do-del/Board_Car/README.md

# Board_Car
Mini平衡小板车
项目目标：做一个非常简易小巧还能遥控的平衡小车
## 功能
- 自平衡
- 可遥控前进后退转弯

## 硬件构成
电路包括双路直流电机驱动、主控MCU、陀螺仪、电池充放电、调试电路组成，力求精简低成本
- 主控使用STM32F103CBT6，预留SWD调试接口,UART接口
- 陀螺仪使用MPU6050，I2C通讯
- 无线使用RF24无线模块，SPI通讯
- 电机驱动使用L9110SH桥驱动芯片，PWM控制
- 电池充放电使用IP5306，输出5V
