do-del/Board_Car/(list of files, cad)

Other CAD files:
Firmware/Board_Car_STC32/Objects/main.obj
Firmware/Mini_Receiver/Objects/main.obj
Firmware/STC32_TEST/Objects/main.obj
Firmware/Mini_Receiver/Objects/STARTUP.obj
Firmware/STC32_TEST/Objects/timer.obj
Firmware/Board_Car_STC32/Objects/uart.obj
Firmware/Mini_Receiver/Objects/pwm.obj
Firmware/STC32_TEST/Objects/pwm.obj
Firmware/STC32_TEST/Objects/uart.obj
Firmware/Mini_Receiver/Objects/uart.obj
Firmware/Mini_Receiver/Objects/RF24.obj
Firmware/STC32_TEST/Objects/math.obj
Firmware/Mini_Receiver/Objects/eeprom.obj
Firmware/STC32_TEST/Objects/rf24.obj
Firmware/STC32_TEST/Objects/motor.obj
Firmware/STC32_TEST/Objects/spi.obj
Firmware/STC32_TEST/Objects/sys.obj
