do-del/Board_Car/Hardware/Board_Car_V0_3/Board_Car_V0_3.kicad_pcb

## KiCad design Hardware/Board_Car_V0_3/Board_Car_V0_3.kicad_pcb (2023-07-21)

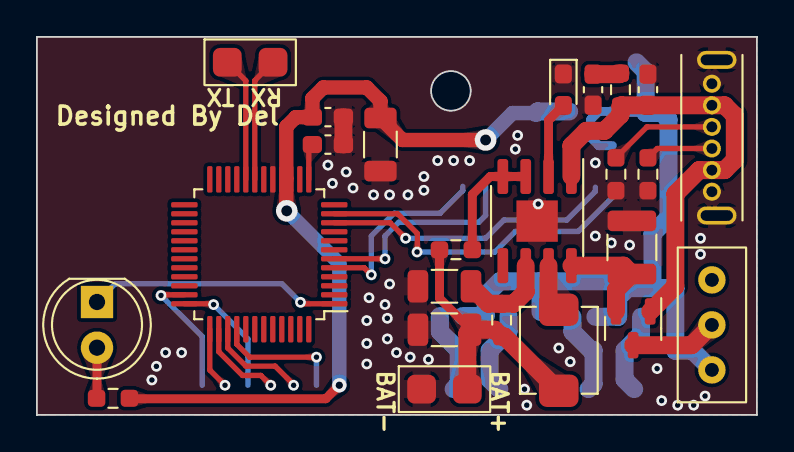
[picture p1: board Board_Car_V0_3.kicad_pcb from above]

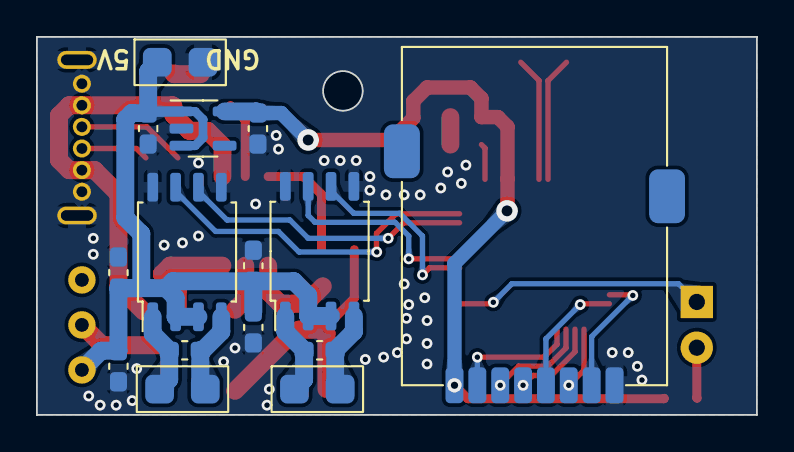
[picture p2: board Board_Car_V0_3.kicad_pcb from below]

Board: 2 copper layers, 40.0 x 21.0 mm, 39 parts (15 on the bottom side), 33 nets.

Parts:
BT2: Battery_Cell; PAD_2P_P2.54mm
C1: 100uF; C_1210_3225Metric
C2, C3, C4, C7, C8, C19: 10uF; C_0603_1608Metric_Pad1.08x0.95mm_HandSolder
C5, C6, C9, C10, C12, C14: 100nF; C_0603_1608Metric_Pad1.08x0.95mm_HandSolder
C11, C13, C17: 22uF; C_1206_3216Metric
D1: BAT54C; SOT-23
D2: LED; LED_D5.0mm
D3: 25%; LED_0603_1608Metric_Pad1.05x0.95mm_HandSolder
J1, J2: Conn_01x02_Pin; PAD_2P_P2.54mm
L1: 1uH; IND0420
M1, M2: Motor_DC; PAD_2P_P2.54mm
R1: 2.2K; R_0603_1608Metric_Pad0.98x0.95mm_HandSolder
R2, R3: 5K1; R_0603_1608Metric_Pad0.98x0.95mm_HandSolder
R11: 2R; R_0603_1608Metric_Pad0.98x0.95mm_HandSolder
R12: 0.5R; R_0603_1608Metric_Pad0.98x0.95mm_HandSolder
R13: 1K; R_0603_1608Metric_Pad0.98x0.95mm_HandSolder
SW3: SW_SPDT; SWITCH_TOGGLE_2.5mm_3P
U1: SPX3819M5-L-3-3; SOT-23-5
U2, U4: L9110S; SOP-8_5.28x5.23mm_P1.27mm
U3: IP5306; HSOP-8-1EP_3.9x4.9mm_P1.27mm_EP2.3x2.3mm
U5: STC32G12K128; LQFP-48_7x7mm_P0.5mm
U7: RF24_SMD
USB1: TYPE-C; TYPE-C_6P_Vertical

Connections:
+3.3V: C13.1, C14.1, C19.1, R1.2, U1.5 (OUT), U5.15 (VCC), U5.16 (ADC_VRef), U7.1 (VCC)
+5V: C1.1, D1.2, U3.8 (VOUT)
+5VD: C3.1, C4.1, C5.1, C8.1, C9.1, J1.1, SW3.1 (A), U1.1 (IN), U1.3 (EN), U2.2 (VDD), U2.3 (VIO), U4.2 (VDD), U4.3 (VIO)
+BATT: BT2.2 (+), C11.1, L1.2, R12.1, R13.2
/LED: D2.1 (K), U5.1 (P5.3)
/PWM1N: U2.7 (BAK), U5.6 (P1.1)
/PWM1P: U2.6 (FOR), U5.5 (P1.0)
/PWM4N: U4.7 (BAK), U5.11 (P1.7)
/PWM4P: U4.6 (FOR), U5.10 (P1.6)
/RF24_CE: U5.40 (P2.7), U7.2 (CE)
/RF24_CSN: U5.39 (P2.6), U7.3 (CSN)
/RF24_IRQ: U5.35 (P2.2), U7.7 (IRQ)
/RF24_MISO: U5.37 (P2.4), U7.6 (MISO)
/RF24_MOSI: U5.36 (P2.3), U7.5 (MOSI)
/RF24_SCK: U5.38 (P2.5), U7.4 (SCK)
/RX: J2.2, U5.19 (P3.0)
/TX: J2.1, U5.20 (P3.1)
GND: BT2.1 (-), C1.2, C2.1, C3.2, C4.2, C5.2, C7.1, C8.2, C9.2, C11.2, C12.2, C13.2, C14.2, C17.2, C19.2, D3.1 (K), J1.2, R2.2, R3.2, U1.2 (GND), U2.5 (GND), U2.8 (GND), U3.9 (PAD), U4.5 (GND), U4.8 (GND), U5.17 (GND), U7.8 (GND), USB1.A12 (GND), USB1.B12 (GND), USB1.MP (SHELL)
unnamed: C2.2, R11.1
unnamed: D2.2 (A), R1.1
unnamed: D3.2 (A), U3.2 (LED1)
unnamed: C6.1, M1.1 (+), U2.1 (X4)
unnamed: C6.2, M1.2 (-), U2.4 (X3)
unnamed: C10.1, M2.1 (+), U4.1 (X4)
unnamed: C10.2, M2.2 (-), U4.4 (X3)
unnamed: D1.3, SW3.2 (B)
unnamed: C17.1, R12.2, U3.6 (BAT)
unnamed: R13.1, U3.3 (LED2), U3.4 (LED3)
unnamed: L1.1, U3.7 (SW)
unnamed: C12.1, U5.13 (UCap)
unnamed: R2.1, USB1.A5 (CC1)
unnamed: R3.1, USB1.B5 (CC2)
VBUS: C7.2, D1.1, R11.2, U3.1 (VIN), USB1.A9 (VBUS), USB1.B9 (VBUS)
