do-del/Board_Car/Hardware/Mini_Remoter/Mini_Remoter.kicad_pcb

## KiCad design Hardware/Mini_Remoter/Mini_Remoter.kicad_pcb (2023-06-18)

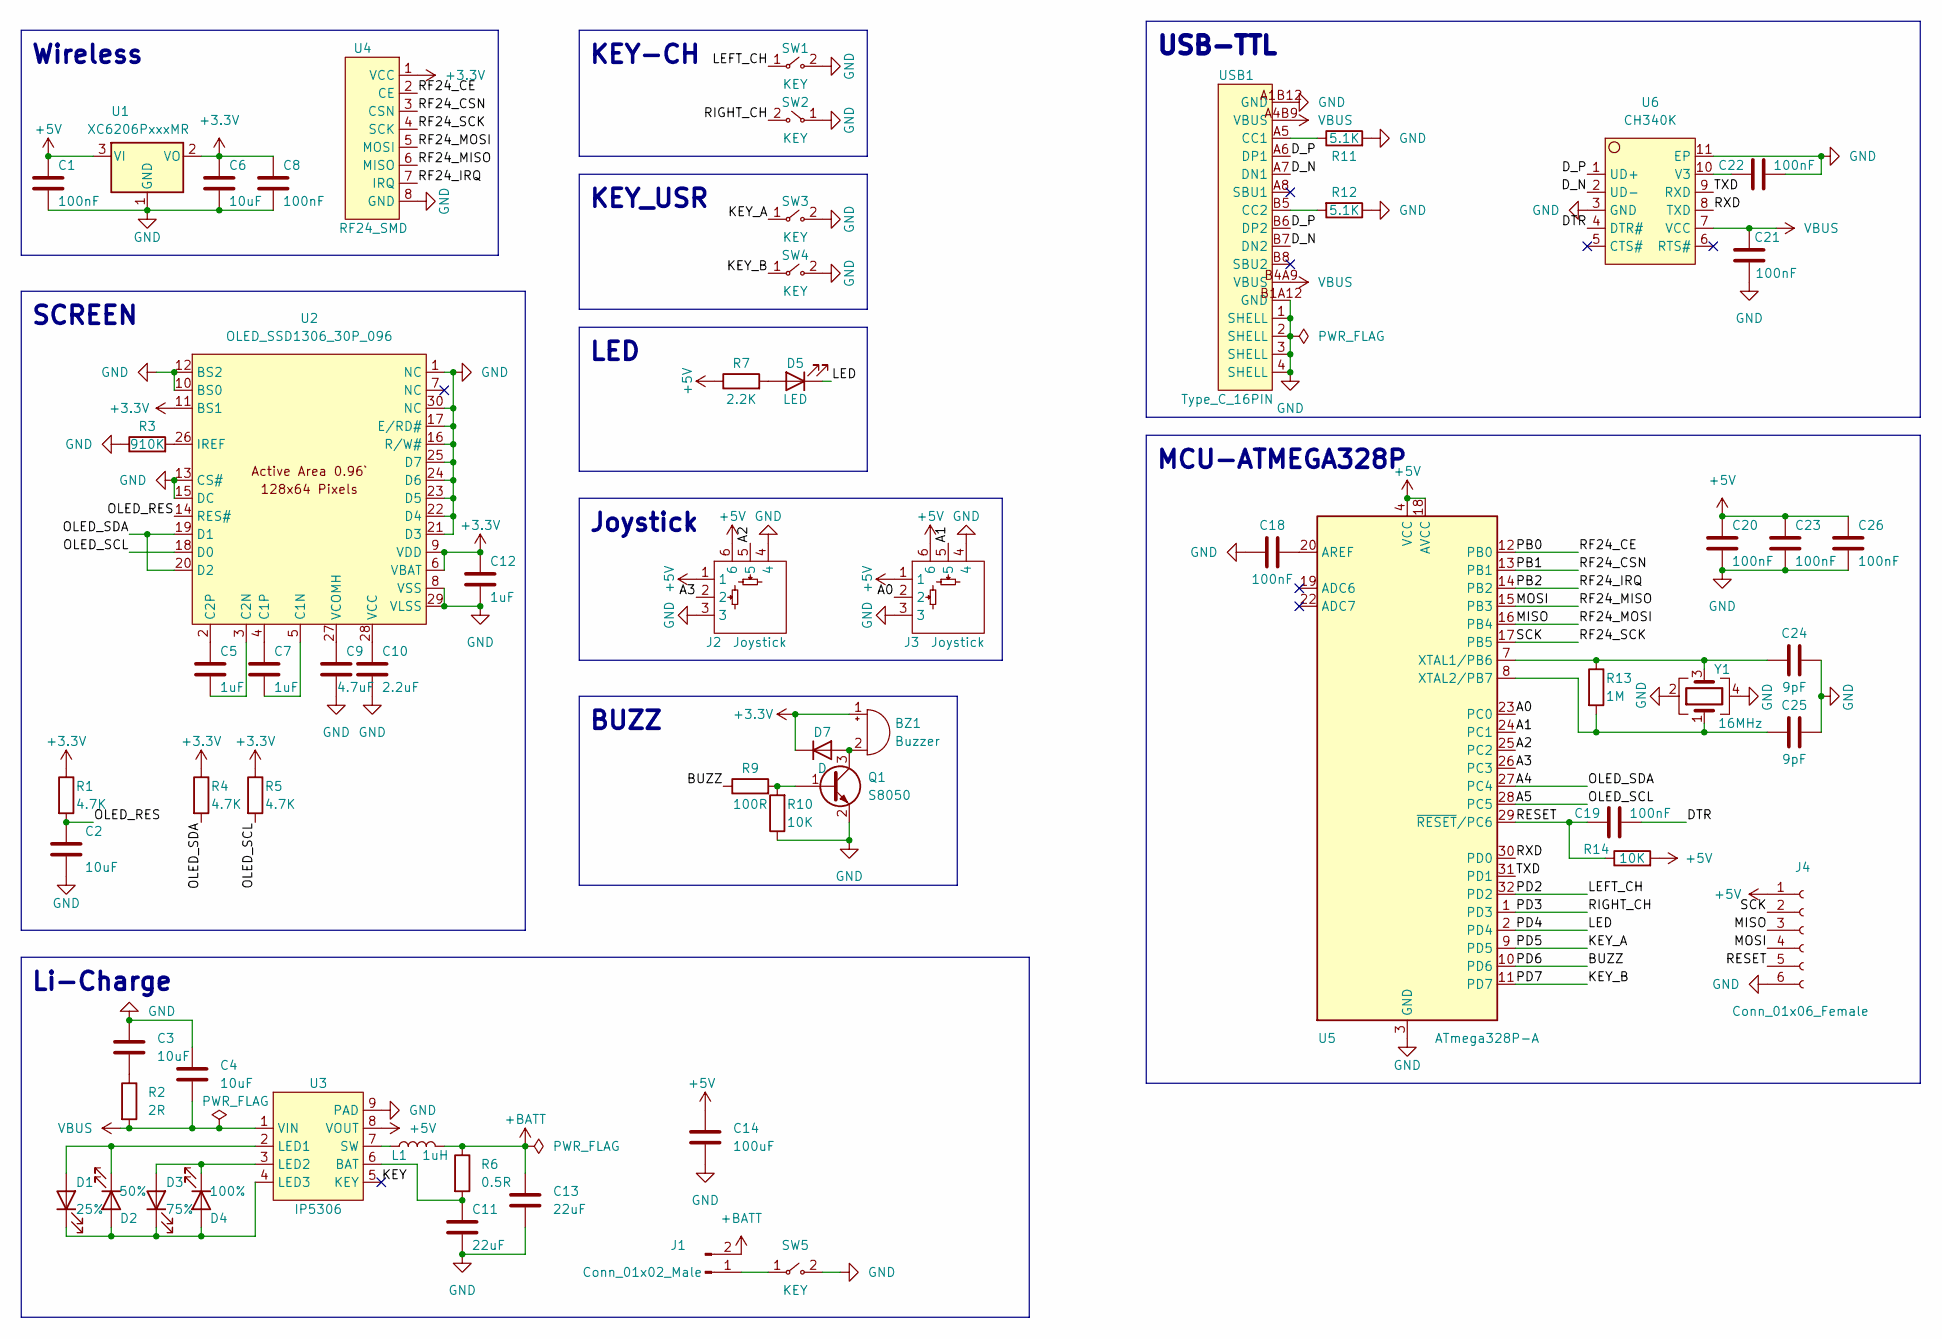
[picture p3: schematic Mini_Remoter.kicad_sch]

Parts:
BZ1: Buzzer; DET402
C1, C8, C18, C19, C20, C21, C22, C23, C26: 100nF; C_0603_1608Metric_Pad1.08x0.95mm_HandSolder
C2, C3, C4, C6: 10uF; C_0603_1608Metric_Pad1.08x0.95mm_HandSolder
C5, C7, C12: 1uF; C_0603_1608Metric_Pad1.08x0.95mm_HandSolder
C9: 4.7uF; C_0603_1608Metric_Pad1.08x0.95mm_HandSolder
C10: 2.2uF; C_0603_1608Metric_Pad1.08x0.95mm_HandSolder
C11, C13: 22uF; C_1206_3216Metric
C14: 100uF; C_1210_3225Metric
C24, C25: 9pF; C_0603_1608Metric_Pad1.08x0.95mm_HandSolder
D1: 25%; LED_0603_1608Metric_Pad1.05x0.95mm_HandSolder
D2: 50%; LED_0603_1608Metric_Pad1.05x0.95mm_HandSolder
D3: 75%; LED_0603_1608Metric_Pad1.05x0.95mm_HandSolder
D4: 100%; LED_0603_1608Metric_Pad1.05x0.95mm_HandSolder
D5: LED; LED_0603_1608Metric_Pad1.05x0.95mm_HandSolder
D7: D; D_SOD-123
J1: Conn_01x02_Male; PH2.0mm-2P-WT
J2, J3: Joystick; PSP_JOYSTICK
J4: Conn_01x06_Female; JST_SHL_SM06B-SHLS-TF_1x06-1MP_P1.00mm_Horizontal
L1: 1uH; IND0420
Q1: S8050; SOT-23
R1, R4, R5: 4.7K; R_0603_1608Metric_Pad0.98x0.95mm_HandSolder
R2: 2R; R_0603_1608Metric_Pad0.98x0.95mm_HandSolder
R3: 910K; R_0603_1608Metric_Pad0.98x0.95mm_HandSolder
R6: 0.5R; R_0603_1608Metric_Pad0.98x0.95mm_HandSolder
R7: 2.2K; R_0603_1608Metric_Pad0.98x0.95mm_HandSolder
R9: 100R; R_0603_1608Metric_Pad0.98x0.95mm_HandSolder
R10, R14: 10K; R_0603_1608Metric_Pad0.98x0.95mm_HandSolder
R11, R12: 5.1K; R_0603_1608Metric_Pad0.98x0.95mm_HandSolder
R13: 1M; R_0603_1608Metric_Pad0.98x0.95mm_HandSolder
SW1, SW2: KEY; SW_2x4x3.5_SIDE
SW3, SW4: KEY; BUTTON_SWITCH_4x4
SW5: KEY; SELFLOCK_SWITCH
U1: XC6206PxxxMR; SOT-23
U2: OLED_SSD1306_30P_096; OLED_12864_30P_P0.7_HOLE
U3: IP5306; HSOP-8-1EP_3.9x4.9mm_P1.27mm_EP2.3x2.3mm
U4: RF24_SMD
U5: ATmega328P-A; TQFP-32_7x7mm_P0.8mm
U6: CH340K; ESSOP-10_P1.0_3.9
USB1: Type_C_16PIN; TYPE-C-16PIN_SMD
Y1: 16MHz; Crystal_SMD_3225-4Pin_3.2x2.5mm

Connections:
+3V3: BZ1.1 (-), C6.1, C8.1, C12.2, D7.1 (K), R1.1, R4.1, R5.1, U1.2 (VO), U2.6 (VBAT), U2.9 (VDD), U2.11 (BS1), U4.1 (VCC)
+5V: C1.1, C14.1, C20.1, C23.1, C26.1, J2.1, J2.6, J3.1, J3.6, J4.1, R7.1, R14.2, U1.3 (VI), U3.8 (VOUT), U5.4 (VCC), U5.6 (VCC), U5.18 (AVCC)
+BATT: C13.1, J1.2, L1.2, R6.1
/A0: J3.2, U5.23 (PC0)
/A1: J3.5, U5.24 (PC1)
/A2: J2.5, U5.25 (PC2)
/A3: J2.2, U5.26 (PC3)
/A4: R4.2, U2.19 (D1), U2.20 (D2), U5.27 (PC4)
/A5: R5.2, U2.18 (D0), U5.28 (PC5)
/BUZZ: R9.1, U5.10 (PD6)
/DTR: C19.1, U6.4 (DTR#)
/D_N: U6.2 (UD-), USB1.A7 (DN1), USB1.B7 (DN2)
/D_P: U6.1 (UD+), USB1.A6 (DP1), USB1.B6 (DP2)
/KEY: U3.5 (KEY)
/KEY_A: SW3.1 (A), U5.9 (PD5)
/LED: D5.1 (K), U5.2 (PD4)
/LEFT_CH: SW1.1 (A), U5.32 (PD2)
/MISO: J4.3, U4.5 (MOSI), U5.16 (PB4)
/MOSI: J4.4, U4.6 (MISO), U5.15 (PB3)
/OLED_RES: C2.1, R1.2, U2.14 (RES#)
/PB0: U4.2 (CE), U5.12 (PB0)
/PB1: U4.3 (CSN), U5.13 (PB1)
/PD3: SW2.2 (B), U5.1 (PD3)
/PD7: SW4.1 (A), U5.11 (PD7)
/RESET: C19.2, J4.5, R14.1, U5.29 (~RESET/PC6)
/RF24_IRQ: U4.7 (IRQ), U5.14 (PB2)
/RF24_SCK: J4.2, U4.4 (SCK), U5.17 (PB5)
/RXD: U5.30 (PD0), U6.8 (TXD)
/TXD: U5.31 (PD1), U6.9 (RXD)
GND: C1.2, C2.2, C3.1, C4.1, C6.2, C8.2, C9.1, C10.1, C11.2, C12.1, C13.2, C14.2, C18.1, C20.2, C21.1, C22.1, C23.2, C24.2, C25.2, C26.2, J2.3, J2.4, J3.3, J3.4, J4.6, Q1.2 (E), R3.1, R10.1, R11.2, R12.1, SW1.2 (B), SW2.1 (A), SW3.2 (B), SW4.2 (B), SW5.2 (B), U1.1 (GND), U2.1 (NC), U2.8 (VSS), U2.10 (BS0), U2.12 (BS2), U2.13 (CS#), U2.15 (DC), U2.16 (R/W#), U2.17 (E/RD#), U2.21 (D3), U2.22 (D4), U2.23 (D5), U2.24 (D6), U2.25 (D7), U2.29 (VLSS), U2.30 (NC), U3.9 (PAD), U4.8 (GND), U5.3 (GND), U5.5 (GND), U5.21 (GND), U6.3 (GND), U6.11 (EP), USB1.1 (SHELL), USB1.2 (SHELL), USB1.3 (SHELL), USB1.4 (SHELL), USB1.A1B12 (GND), USB1.B1A12 (GND), Y1.2, Y1.4
unnamed: BZ1.2 (+), D7.2 (A), Q1.3 (C)
unnamed: C3.2, R2.1
unnamed: C5.1, U2.3 (C2N)
unnamed: C5.2, U2.2 (C2P)
unnamed: C7.1, U2.5 (C1N)
unnamed: C7.2, U2.4 (C1P)
unnamed: C9.2, U2.27 (VCOMH)
unnamed: C10.2, U2.28 (VCC)
unnamed: C11.1, R6.2, U3.6 (BAT)
unnamed: C18.2, U5.20 (AREF)
unnamed: C22.2, U6.10 (V3)
unnamed: C24.1, R13.1, U5.7 (XTAL1/PB6), Y1.3
unnamed: C25.1, R13.2, U5.8 (XTAL2/PB7), Y1.1
unnamed: D1.1 (K), D2.2 (A), D3.1 (K), D4.2 (A), U3.4 (LED3)
unnamed: D1.2 (A), D2.1 (K), U3.2 (LED1)
unnamed: D3.2 (A), D4.1 (K), U3.3 (LED2)
unnamed: D5.2 (A), R7.2
unnamed: J1.1, SW5.1 (A)
unnamed: L1.1, U3.7 (SW)
unnamed: Q1.1 (B), R9.2, R10.2
unnamed: R3.2, U2.26 (IREF)
unnamed: R11.1, USB1.A5 (CC1)
unnamed: R12.2, USB1.B5 (CC2)
VBUS: C4.2, C21.2, R2.2, U3.1 (VIN), U6.7 (VCC), USB1.A4B9 (VBUS), USB1.B4A9 (VBUS)

Notes on the sheet:
MCU-ATMEGA328P
USB-TTL
Joystick
Li-Charge
KEY_USR
KEY-CH
LED
SCREEN
BUZZ
Wireless

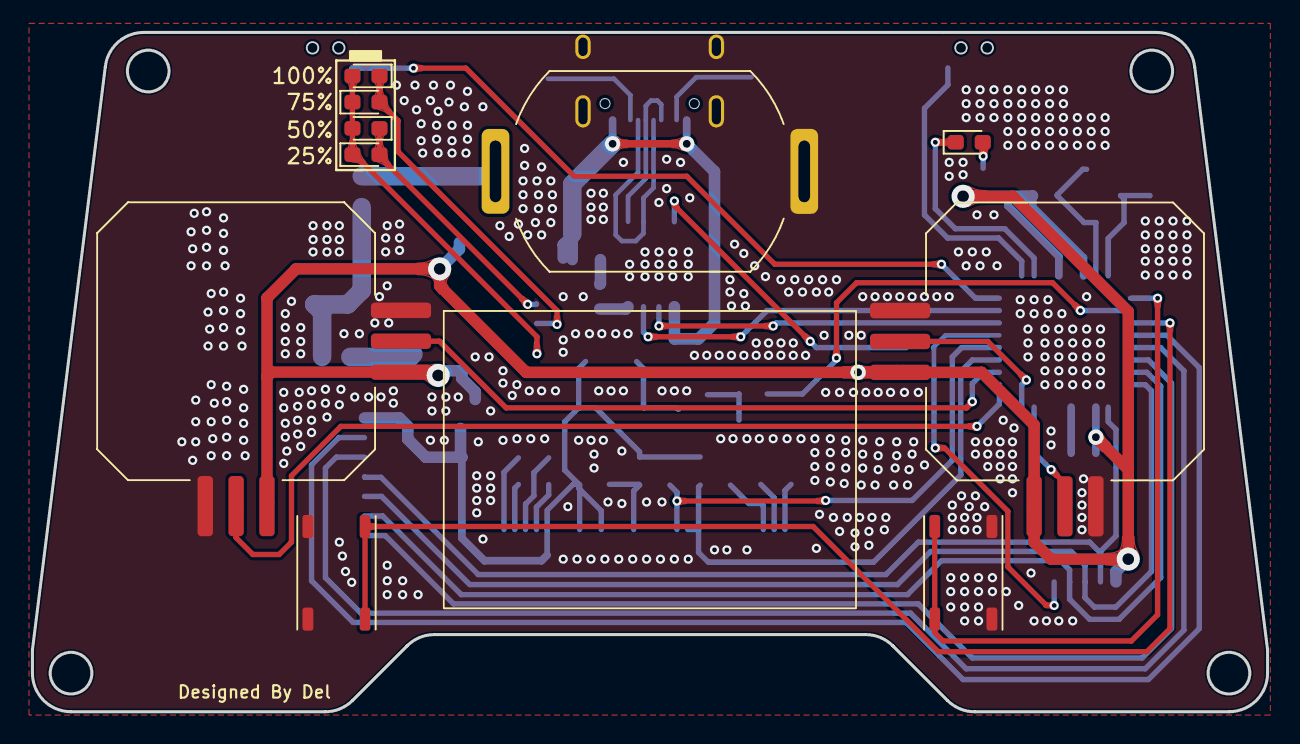
[picture p4: board Mini_Remoter.kicad_pcb from above]

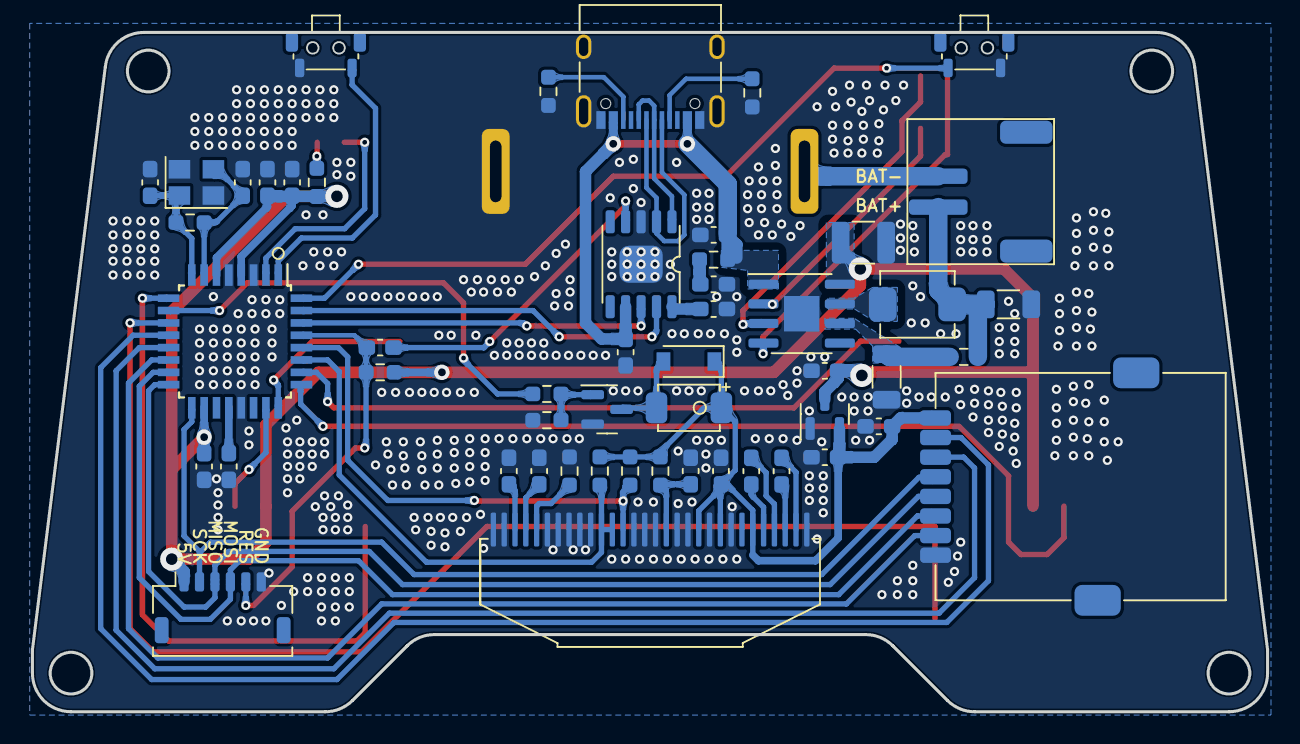
[picture p5: board Mini_Remoter.kicad_pcb from below]

Board: 2 copper layers, 80.0 x 44.0 mm, 62 parts (51 on the bottom side), 53 nets.
