do-del/Board_Car/Hardware/Board_Car_V0_2/Board_Car_V0_2.kicad_pcb

## KiCad design Hardware/Board_Car_V0_2/Board_Car_V0_2.kicad_pcb (2023-06-08, an earlier design)

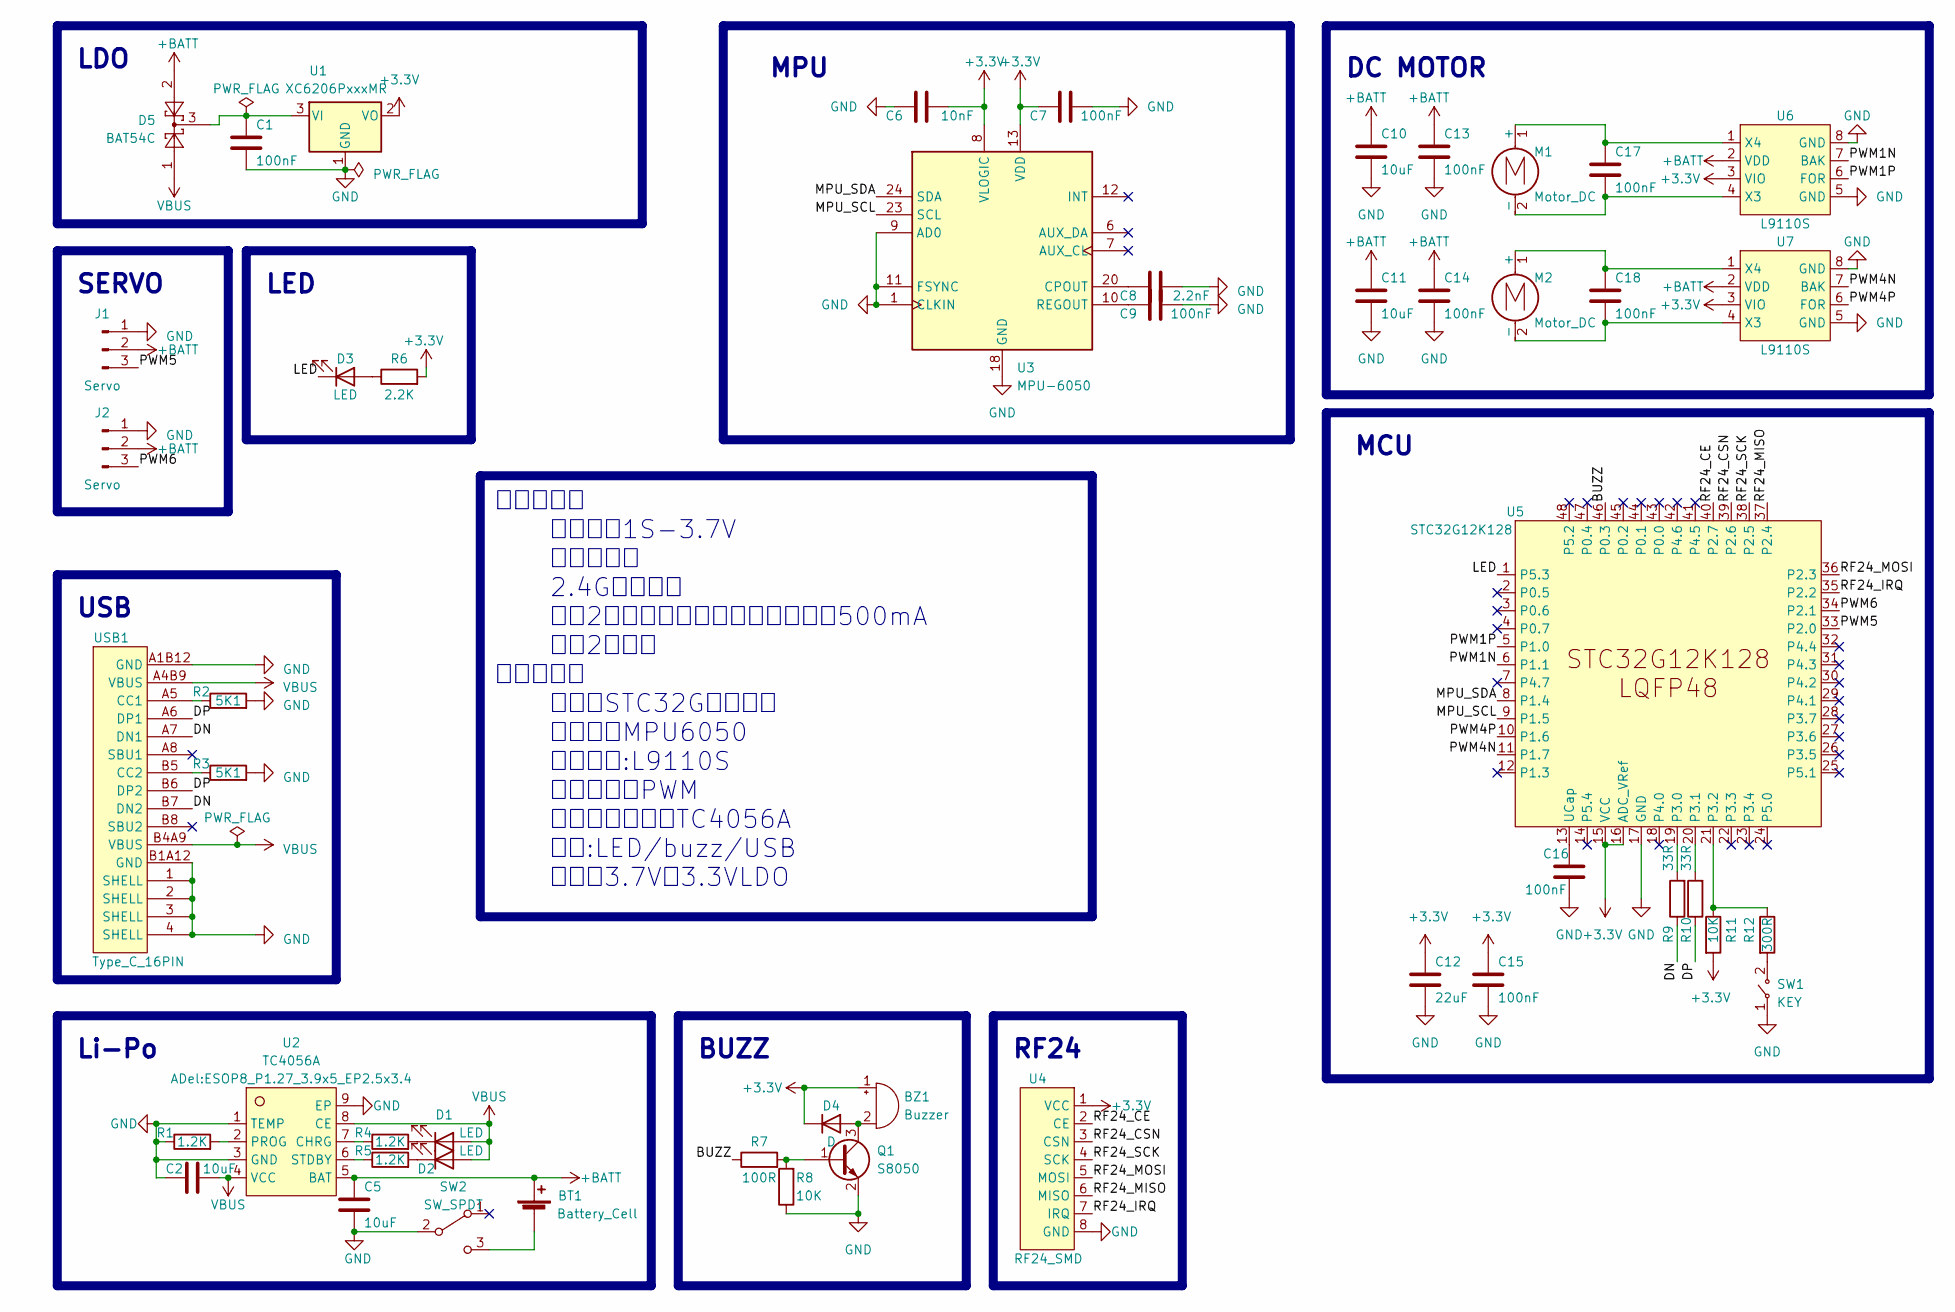
[picture p6: schematic Board_Car_V0_2.kicad_sch]

Parts:
BT1: Battery_Cell; PH2.0_2P_LT
BZ1: Buzzer; DET402
C1, C7, C9, C13, C14, C15, C16, C17, C18: 100nF; C_0603_1608Metric_Pad1.08x0.95mm_HandSolder
C2, C5, C10, C11: 10uF; C_0603_1608Metric_Pad1.08x0.95mm_HandSolder
C6: 10nF; C_0603_1608Metric_Pad1.08x0.95mm_HandSolder
C8: 2.2nF; C_0603_1608Metric_Pad1.08x0.95mm_HandSolder
C12: 22uF; C_1206_3216Metric
D1, D2, D3: LED; LED_0603_1608Metric_Pad1.05x0.95mm_HandSolder
D4: D; D_SOD-123
D5: BAT54C; SOT-23
J1, J2: Servo; PinHeader_1x03_P2.54mm_Vertical
M1, M2: Motor_DC; PH2.0_2P_LT
Q1: S8050; SOT-23
R1, R4, R5: 1.2K; R_0603_1608Metric_Pad0.98x0.95mm_HandSolder
R2, R3: 5K1; R_0603_1608Metric_Pad0.98x0.95mm_HandSolder
R6: 2.2K; R_0603_1608Metric_Pad0.98x0.95mm_HandSolder
R7: 100R; R_0603_1608Metric_Pad0.98x0.95mm_HandSolder
R8, R11: 10K; R_0603_1608Metric_Pad0.98x0.95mm_HandSolder
R9, R10: 33R; R_0603_1608Metric_Pad0.98x0.95mm_HandSolder
R12: 300R; R_0603_1608Metric_Pad0.98x0.95mm_HandSolder
SW1: KEY; SW_2x4x3.5_SIDE
SW2: SW_SPDT; SW_SPDT_CK-JS102011SAQN
U1: XC6206PxxxMR; SOT-23
U2: TC4056A; ESOP8_P1.27_3.9x5_EP2.5x3.4
U3: MPU-6050; InvenSense_QFN-24_4x4mm_P0.5mm
U4: RF24_SMD
U5: STC32G12K128; LQFP-48_7x7mm_P0.5mm
U6, U7: L9110S; SOP-8_5.28x5.23mm_P1.27mm
USB1: Type_C_16PIN; TYPE-C-16PIN_SMD

Connections:
+3.3V: BZ1.1 (-), C6.2, C7.1, C12.1, C15.1, D4.1 (K), R6.2, R11.2, U1.2 (VO), U3.8 (VLOGIC), U3.13 (VDD), U4.1 (VCC), U5.15 (VCC), U5.16 (ADC_VRef), U6.3 (VIO), U7.3 (VIO)
+BATT: BT1.2 (+), C5.1, C10.1, C11.1, C13.1, C14.1, D5.2, J1.2, J2.2, U2.5 (BAT), U6.2 (VDD), U7.2 (VDD)
/BUZZ: R7.1, U5.46 (P0.3)
/DN: R9.1, USB1.A7 (DN1), USB1.B7 (DN2)
/DP: R10.1, USB1.A6 (DP1), USB1.B6 (DP2)
/LED: D3.1 (K), U5.1 (P5.3)
/MPU_SCL: U3.23 (SCL), U5.9 (P1.5)
/MPU_SDA: U3.24 (SDA), U5.8 (P1.4)
/PWM1N: U5.6 (P1.1), U6.7 (BAK)
/PWM1P: U5.5 (P1.0), U6.6 (FOR)
/PWM4N: U5.11 (P1.7), U7.7 (BAK)
/PWM4P: U5.10 (P1.6), U7.6 (FOR)
/PWM5: J1.3, U5.33 (P2.0)
/PWM6: J2.3, U5.34 (P2.1)
/RF24_CE: U4.2 (CE), U5.40 (P2.7)
/RF24_CSN: U4.3 (CSN), U5.39 (P2.6)
/RF24_IRQ: U4.7 (IRQ), U5.35 (P2.2)
/RF24_MISO: U4.6 (MISO), U5.37 (P2.4)
/RF24_MOSI: U4.5 (MOSI), U5.36 (P2.3)
/RF24_SCK: U4.4 (SCK), U5.38 (P2.5)
GND: C1.2, C2.1, C5.2, C6.1, C7.2, C8.2, C9.2, C10.2, C11.2, C12.2, C13.2, C14.2, C15.2, C16.2, J1.1, J2.1, Q1.2 (E), R1.1, R2.2, R3.2, R8.1, SW1.1 (A), SW2.2 (B), U1.1 (GND), U2.1 (TEMP), U2.3 (GND), U2.9 (EP), U3.1 (CLKIN), U3.9 (AD0), U3.11 (FSYNC), U3.18 (GND), U4.8 (GND), U5.17 (GND), U6.5 (GND), U6.8 (GND), U7.5 (GND), U7.8 (GND), USB1.1 (SHELL), USB1.2 (SHELL), USB1.3 (SHELL), USB1.4 (SHELL), USB1.A1B12 (GND), USB1.B1A12 (GND)
unnamed: BT1.1 (-), SW2.3 (C)
unnamed: BZ1.2 (+), D4.2 (A), Q1.3 (C)
unnamed: D1.1 (K), R4.2
unnamed: D2.1 (K), R5.2
unnamed: D3.2 (A), R6.1
unnamed: C17.1, M1.1 (+), U6.1 (X4)
unnamed: C17.2, M1.2 (-), U6.4 (X3)
unnamed: C18.1, M2.1 (+), U7.1 (X4)
unnamed: C18.2, M2.2 (-), U7.4 (X3)
unnamed: Q1.1 (B), R7.2, R8.2
unnamed: R12.2, SW1.2 (B)
unnamed: C1.1, D5.3, U1.3 (VI)
unnamed: R4.1, U2.7 (CHRG)
unnamed: R1.2, U2.2 (PROG)
unnamed: R5.1, U2.6 (STDBY)
unnamed: C8.1, U3.20 (CPOUT)
unnamed: C9.1, U3.10 (REGOUT)
unnamed: R9.2, U5.19 (P3.0)
unnamed: R10.2, U5.20 (P3.1)
unnamed: R11.1, R12.1, U5.21 (P3.2)
unnamed: C16.1, U5.13 (UCap)
unnamed: R2.1, USB1.A5 (CC1)
unnamed: R3.1, USB1.B5 (CC2)
VBUS: C2.2, D1.2 (A), D2.2 (A), D5.1, U2.4 (VCC), U2.8 (CE), USB1.A4B9 (VBUS), USB1.B4A9 (VBUS)

Notes on the sheet:
硬件描述： 电池数：1S-3.7V 带报警功能 2.4G无线遥控 控制2路直流电机正反转，最大支持500mA 控制2路舵机 硬件组成： 主控：STC32G最小系统 陀螺仪：MPU6050 电机驱动:L9110S 舵机驱动：PWM 锂电池充放电：TC4056A 调试:LED/buzz/USB 电源：3.7V转3.3VLDO
DC MOTOR
USB
LED
MPU
LDO
Li-Po
SERVO
BUZZ
RF24
MCU

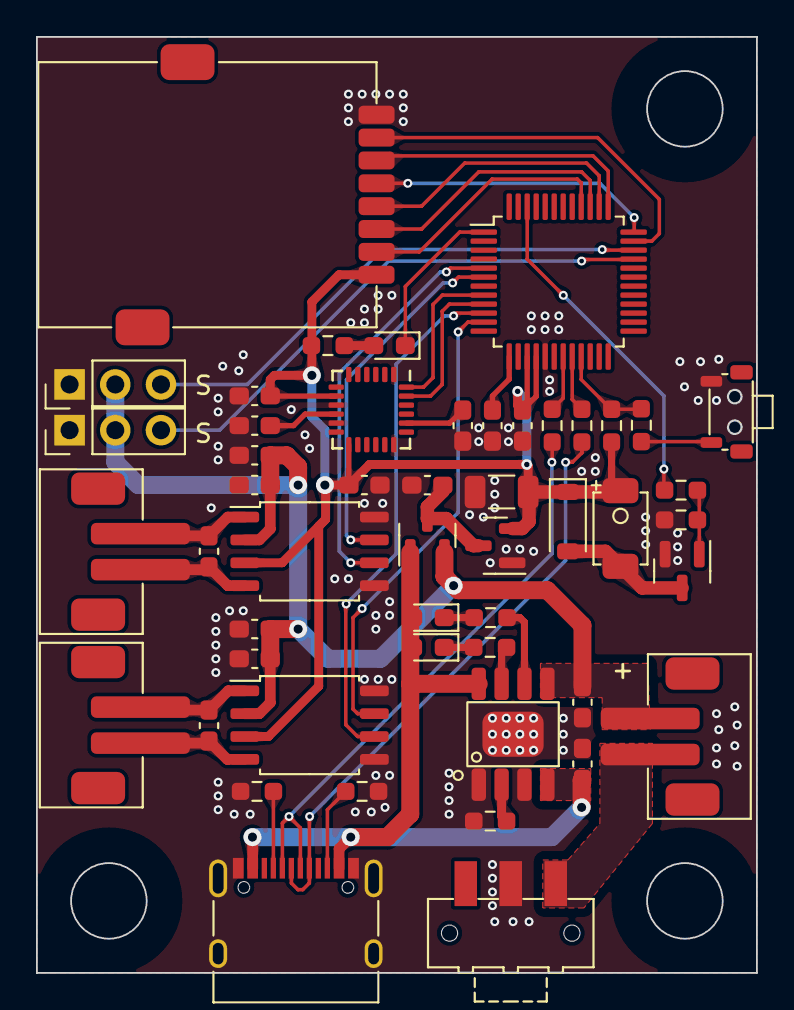
[picture p7: board Board_Car_V0_2.kicad_pcb from above]

Board: 2 copper layers, 40.0 x 52.0 mm, 50 parts (0 on the bottom side), 45 nets.
