do-del/Board_Car/Firmware/Mini_Receiver/sys.h

#ifndef SYS_H
#define SYS_H

#include "stc8h.h"
#include "intrins.h"

#define FOSC 12000000UL

typedef unsigned char uint8_t;
typedef unsigned int uint16_t;
typedef unsigned long uint32_t;
typedef char int8_t;
typedef int int16_t;
typedef long int32_t;

#endif
