do-del/Board_Car/(commit log)

2023-06-02 新建硬件文件夹
    [Board_Car_V0_1.kicad_pcb, Board_Car_V0_1.kicad_sch]
2023-06-02 更新README，添加功能和硬件组成说明
2023-06-08 PCB完成初版设计，待验证
    [Board_Car_V0_2-B_Cu.gbr, Board_Car_V0_2-B_Mask.gbr, Board_Car_V0_2-B_Paste.gbr, Board_Car_V0_2-B_Silkscreen.gbr, Board_Car_V0_2-Edge_Cuts.gbr, Board_Car_V0_2-F_Cu.gbr, Board_Car_V0_2-F_Mask.gbr, Board_Car_V0_2-F_Paste.gbr]
2023-06-16 硬件上传
2023-06-16 添加电灯程序
    [main.obj]
2023-06-18 补充测试PCB调试程序
    [Mini_Remoter-B_Cu.gbr, Mini_Remoter-B_Mask.gbr, Mini_Remoter-B_Paste.gbr, Mini_Remoter-B_Silkscreen.gbr, Mini_Remoter-Edge_Cuts.gbr, Mini_Remoter-F_Cu.gbr, Mini_Remoter-F_Mask.gbr, Mini_Remoter-F_Paste.gbr]
2023-06-19 测试通过软件SPI的RF24L01程序
2023-06-20 RF24测试通过
2023-07-18 添加新PCB
    [Board_Car_V0_3-B_Cu.gbr, Board_Car_V0_3-B_Mask.gbr, Board_Car_V0_3-B_Paste.gbr, Board_Car_V0_3-B_Silkscreen.gbr, Board_Car_V0_3-Edge_Cuts.gbr, Board_Car_V0_3-F_Cu.gbr, Board_Car_V0_3-F_Mask.gbr, Board_Car_V0_3-F_Paste.gbr]
2023-07-20 添加测试程序
    [main.obj, pwm.obj]
2023-07-21 版本0.03验证完成
    [Board_Car_V0_3.kicad_pcb, main.obj, math.obj, motor.obj, pwm.obj, rf24.obj, spi.obj, sys.obj]
